djh-mcb/Shoes-prototype/README.md

# Shoes-prototype
**For full documentation, see Shoes_Documentation.pdf**

A fully wireless, wearable, foot-controlled instrument/interface for live performance. 

*Note: Max/MSP is a visual coding language, and as such the textual representation provided by Github is incomprehensible. Please download any .maxpat files and open them in Max/MSP*
